xtremejames1/boatagent/results/parts/preview.png

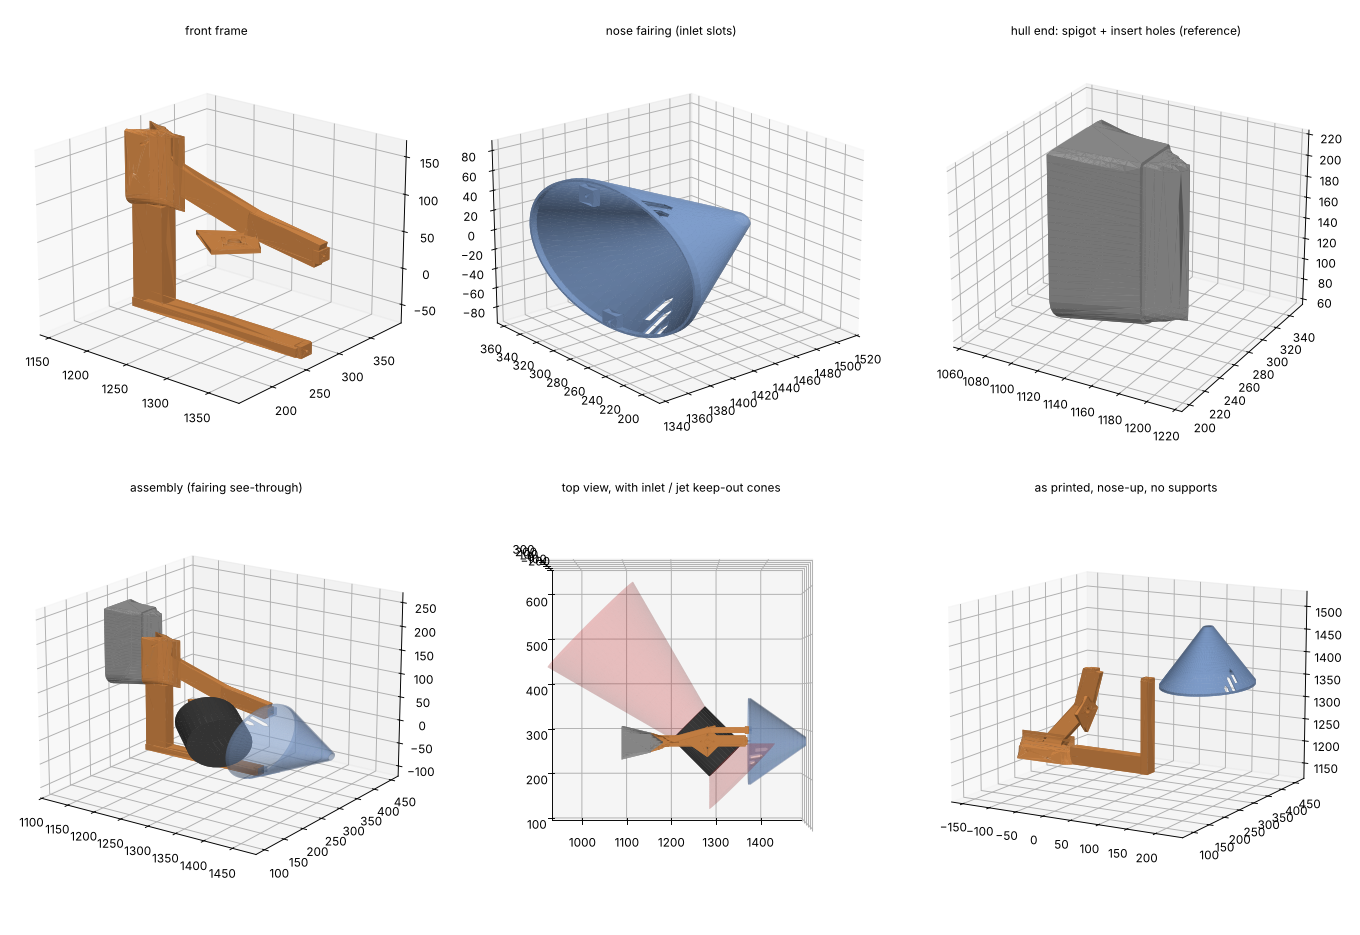
results/parts/preview.png
