xtremejames1/boatagent/results/stage2/designs/finalist_6_assembly.stl

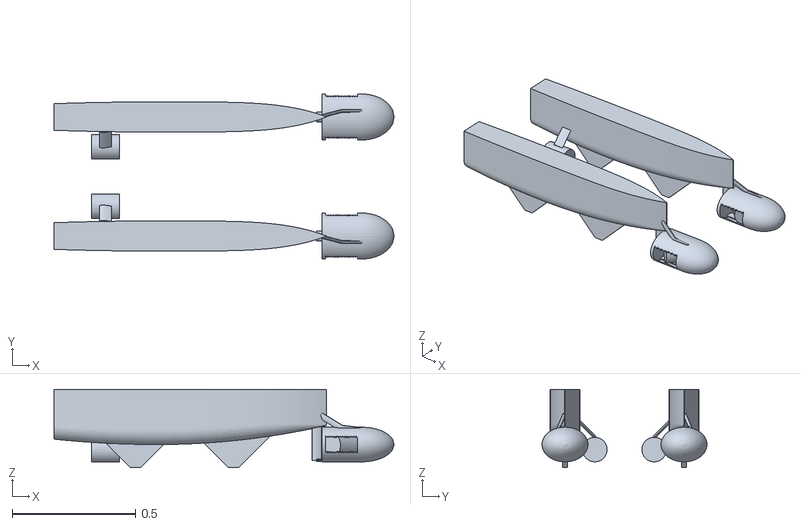
[picture p2: CAD file, 2026-10-28]
results/stage2/designs/finalist_6_assembly.stl
1.38 x 0.67 x 0.317
