xtremejames1/boatagent/results/stage2/designs/finalist_3_assembly.stl

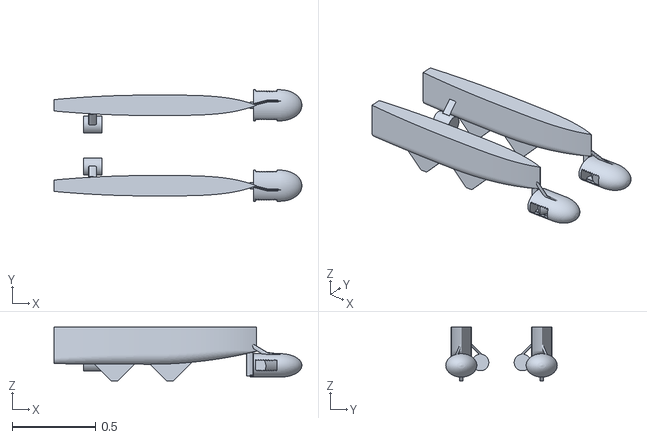
[picture p3: CAD file, 2026-10-28]
results/stage2/designs/finalist_3_assembly.stl
1.49 x 0.67 x 0.324
