xtremejames1/boatagent/results/parts/front_assembly.stl

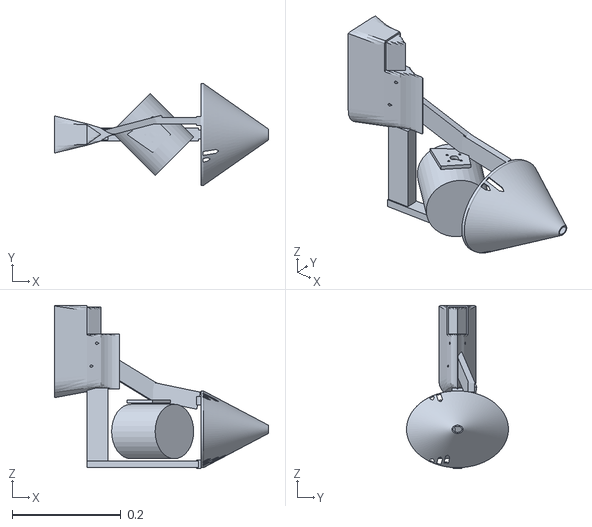
[picture p4: CAD file, 2026-10-28]
results/parts/front_assembly.stl
0.393 x 0.187 x 0.299
