xtremejames1/boatagent/results/stage2/designs/finalist_8_assembly.stl

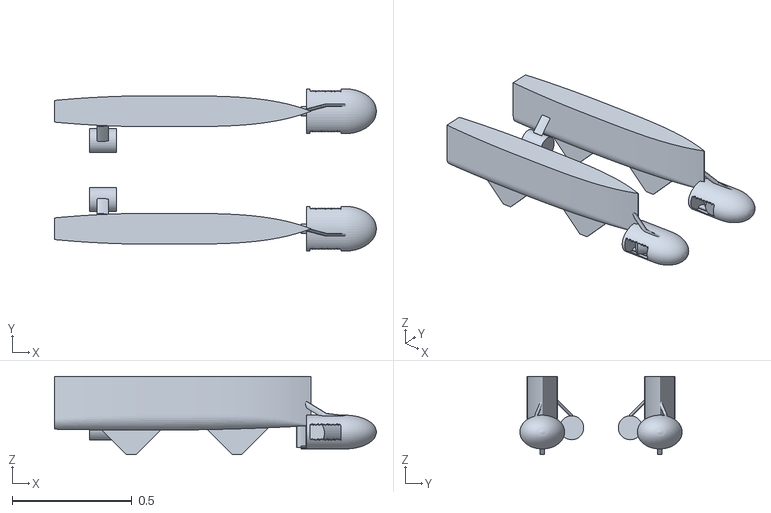
[picture p5: CAD file, 2026-10-28]
results/stage2/designs/finalist_8_assembly.stl
1.34 x 0.677 x 0.325
