xtremejames1/boatagent/results/stage2/designs/finalist_1_assembly.stl

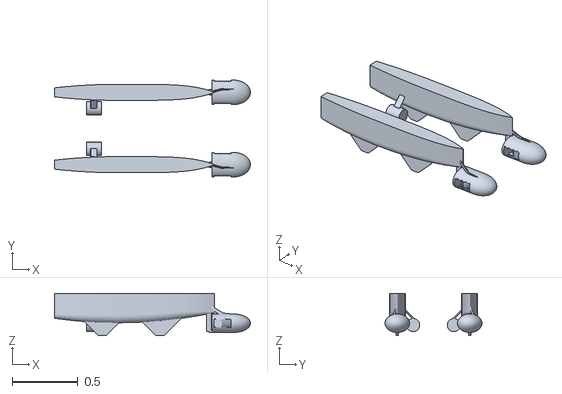
[picture p6: CAD file, 2026-10-28]
results/stage2/designs/finalist_1_assembly.stl
1.49 x 0.737 x 0.321
