xtremejames1/boatagent/results/parts/front_frame_print.stl

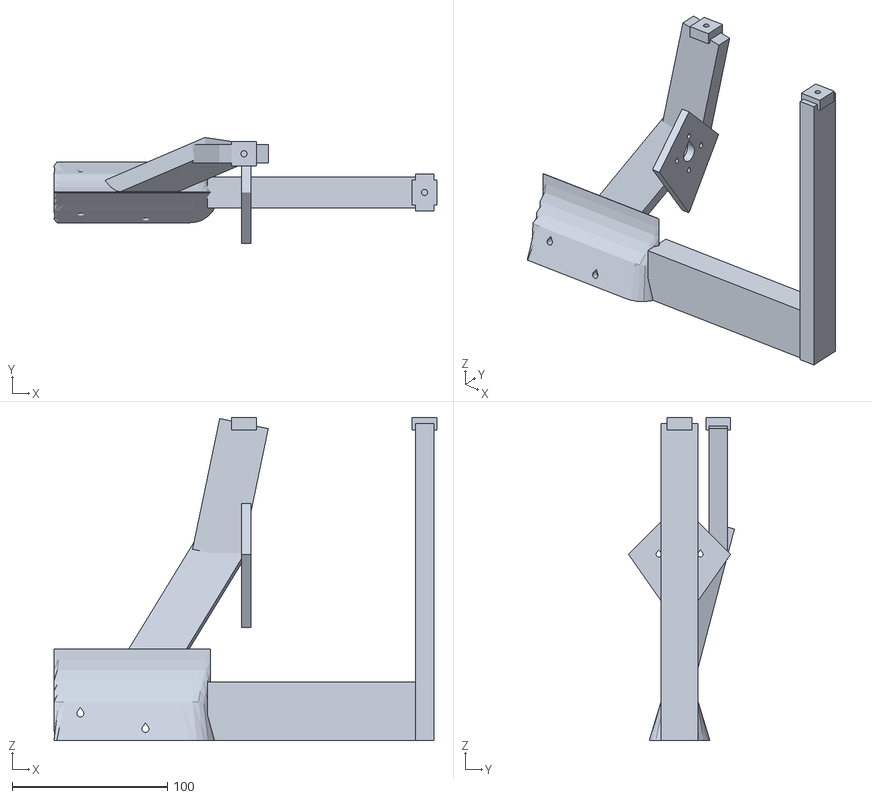
[picture p7: CAD file, 2026-10-28]
results/parts/front_frame_print.stl
247.0 x 68.4 x 208.4
