xtremejames1/boatagent/results/stage1/designs/min_mass_catamaran.stl

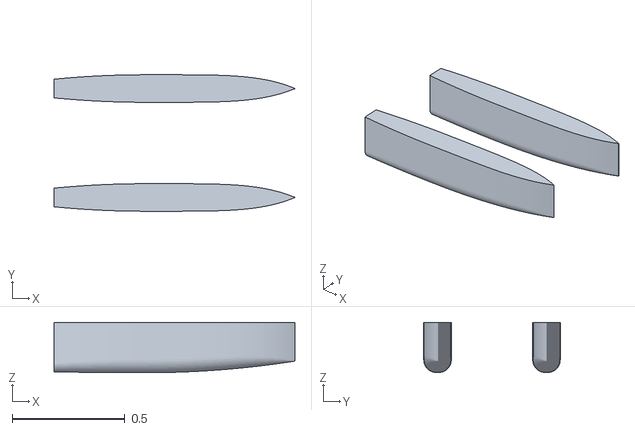
[picture p8: CAD file, 2026-10-28]
results/stage1/designs/min_mass_catamaran.stl
1.07 x 0.606 x 0.224
