xtremejames1/boatagent/results/test_hull_2ft/demihull_smooth.step

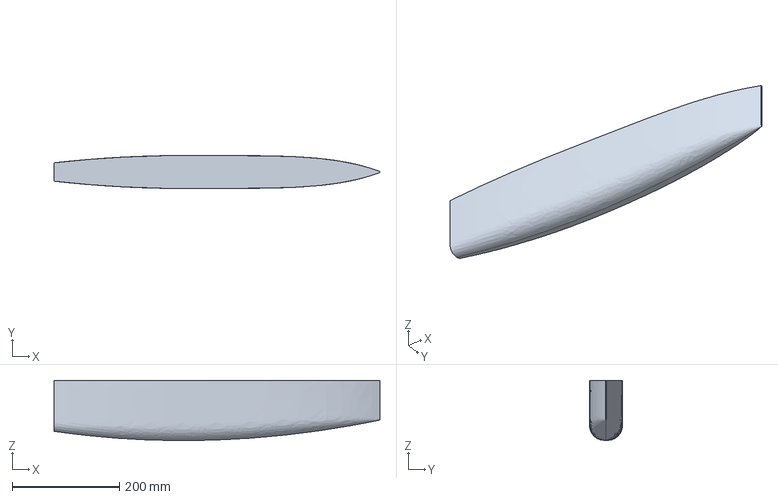
[picture p9: CAD file, 2026-10-28]
results/test_hull_2ft/demihull_smooth.step
607.2 x 61.4 x 112.1 mm
