xtremejames1/boatagent/results/test_hull_2ft_8kg/catamaran.stl

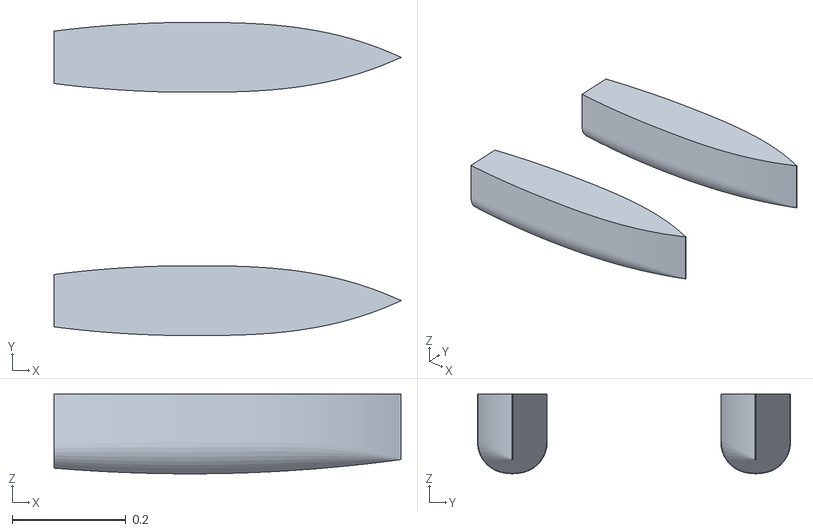
[picture p10: CAD file, 2026-10-28]
results/test_hull_2ft_8kg/catamaran.stl
0.61 x 0.55 x 0.14
