xtremejames1/boatagent/results/parts/front_fairing_print.stl

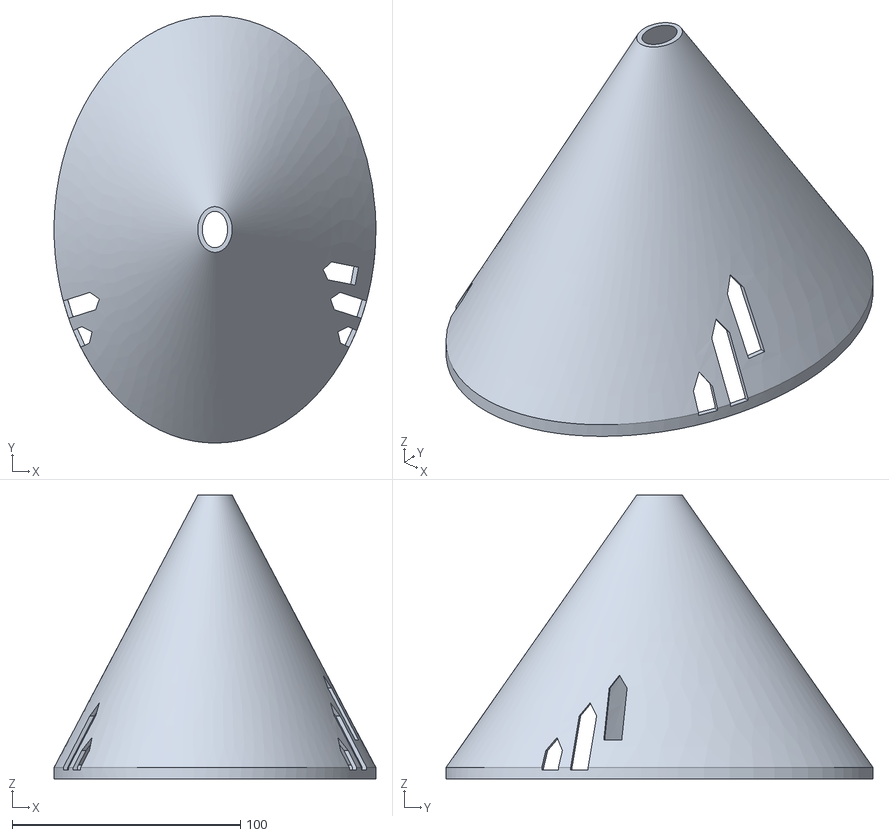
[picture p11: CAD file, 2026-10-28]
results/parts/front_fairing_print.stl
141.0 x 187.0 x 124.3
