xtremejames1/boatagent/results/stage1/designs/min_drag_catamaran.stl

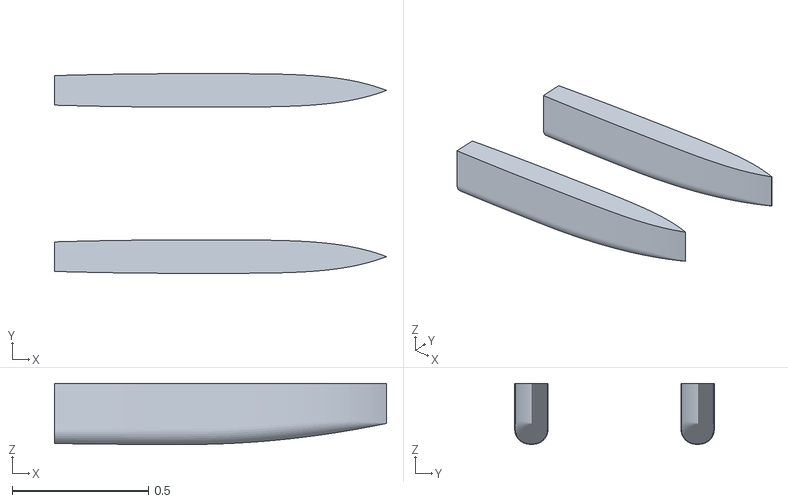
[picture p12: CAD file, 2026-10-28]
results/stage1/designs/min_drag_catamaran.stl
1.22 x 0.732 x 0.224
