xtremejames1/boatagent/results/stage2/designs/finalist_2_catamaran.stl

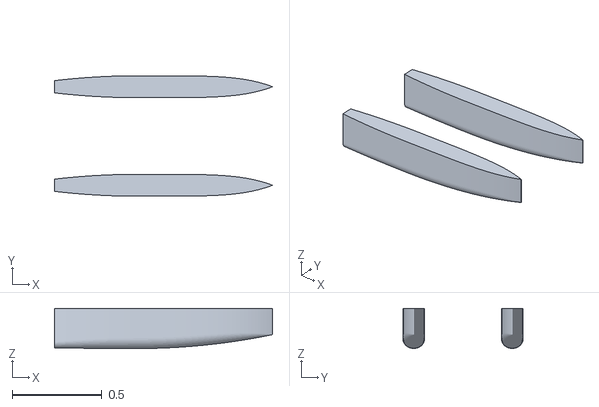
[picture p13: CAD file, 2026-10-28]
results/stage2/designs/finalist_2_catamaran.stl
1.22 x 0.672 x 0.224
