xtremejames1/boatagent/results/test_hull_2ft/demihull_piece1.step

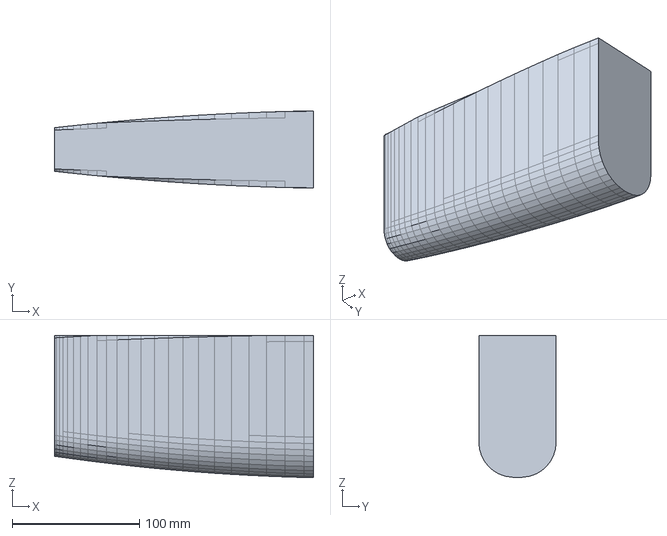
[picture p14: CAD file, 2026-10-28]
results/test_hull_2ft/demihull_piece1.step
203.2 x 60.7 x 111.7 mm
