xtremejames1/boatagent/results/test_hull_2ft_8kg/demihull_smooth.step

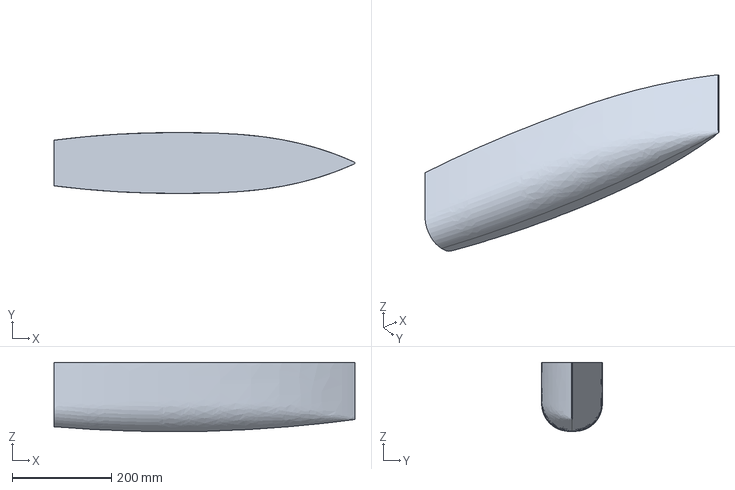
[picture p15: CAD file, 2026-10-28]
results/test_hull_2ft_8kg/demihull_smooth.step
607.2 x 122.7 x 140.0 mm
