xtremejames1/boatagent/results/test_hull_2ft_8kg/demihull.stl

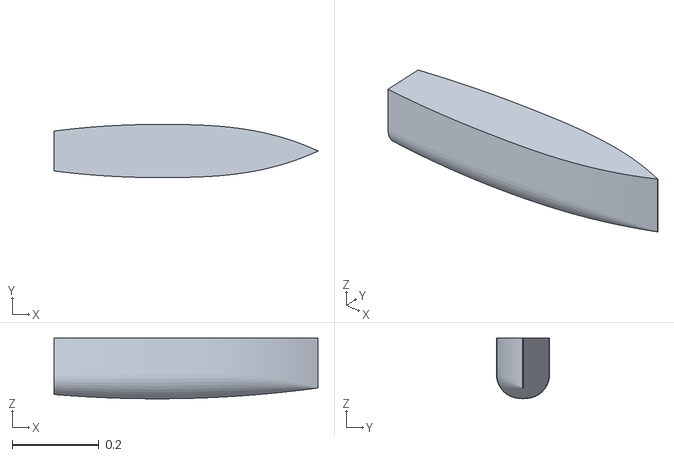
[picture p16: CAD file, 2026-10-28]
results/test_hull_2ft_8kg/demihull.stl
0.61 x 0.123 x 0.14
