xtremejames1/boatagent/results/parts/front_keepout_cones.stl

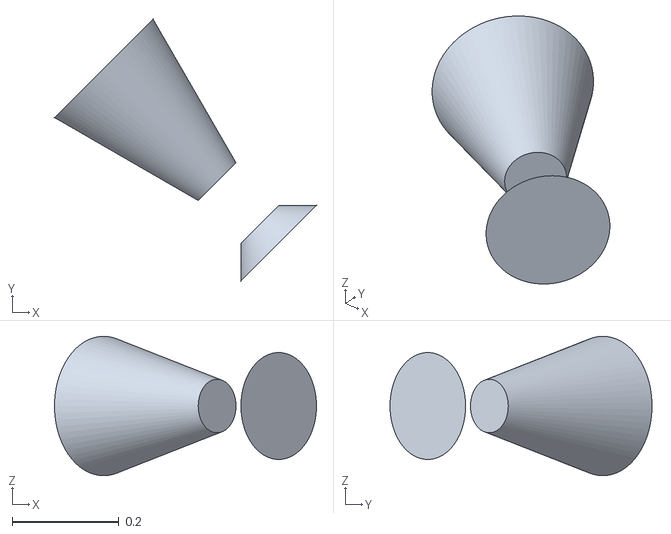
[picture p17: CAD file, 2026-10-28]
results/parts/front_keepout_cones.stl
0.49 x 0.49 x 0.261
