xtremejames1/boatagent/results/test_hull_2ft/demihull_piece2_print.stl

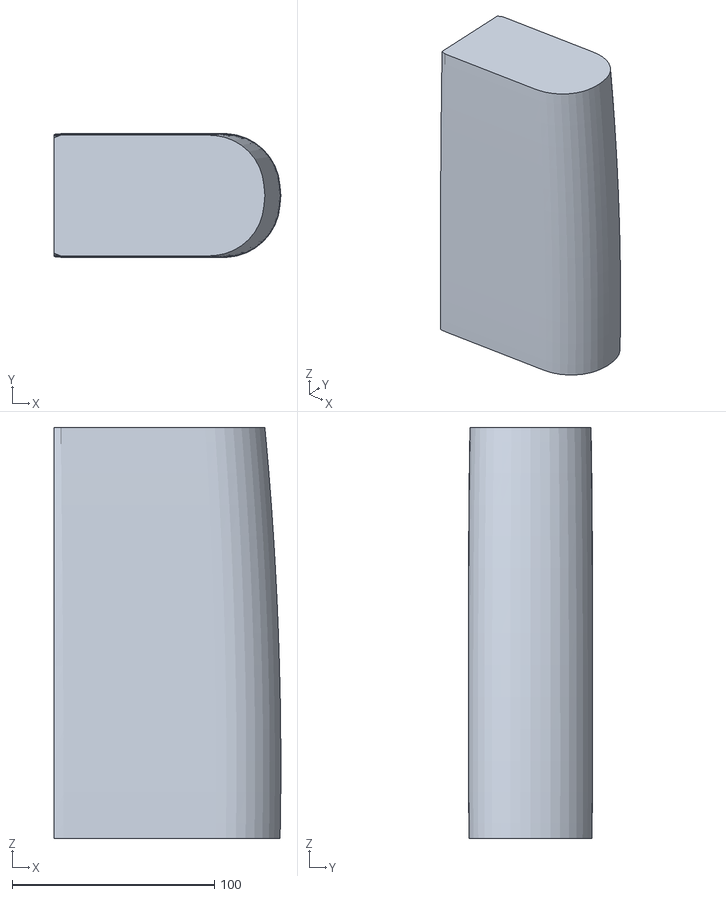
[picture p18: CAD file, 2026-10-28]
results/test_hull_2ft/demihull_piece2_print.stl
112.1 x 61.3 x 203.2
