xtremejames1/boatagent/results/parts/hull_bow_spigot.step

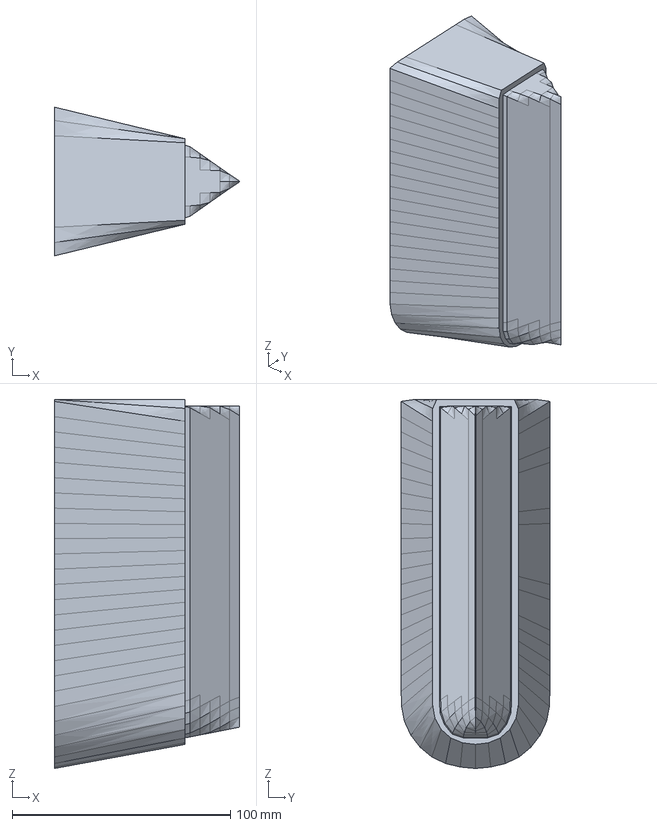
[picture p19: CAD file, 2026-10-28]
results/parts/hull_bow_spigot.step
85.0 x 68.2 x 169.3 mm
