xtremejames1/boatagent/results/test_hull_2ft/catamaran.stl

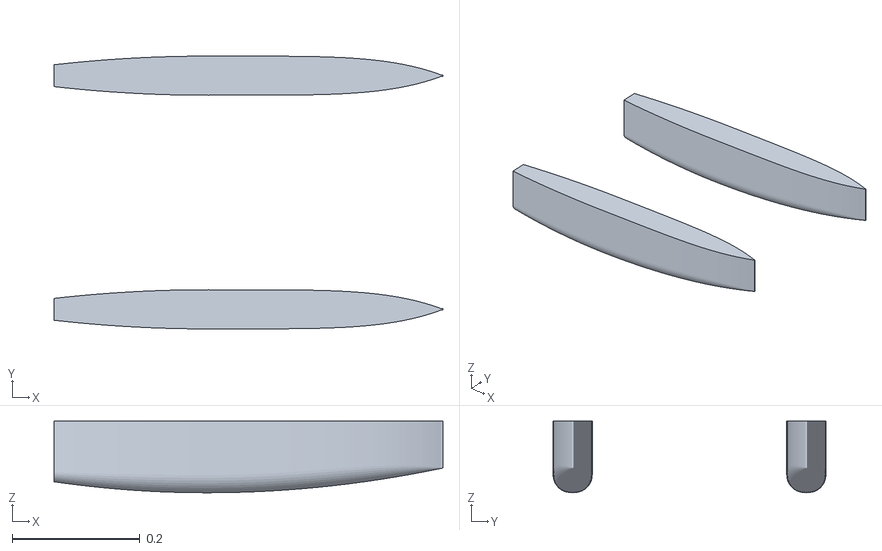
[picture p20: CAD file, 2026-10-28]
results/test_hull_2ft/catamaran.stl
0.61 x 0.427 x 0.112
