xtremejames1/boatagent/results/stage2/designs/finalist_1_pod.stl

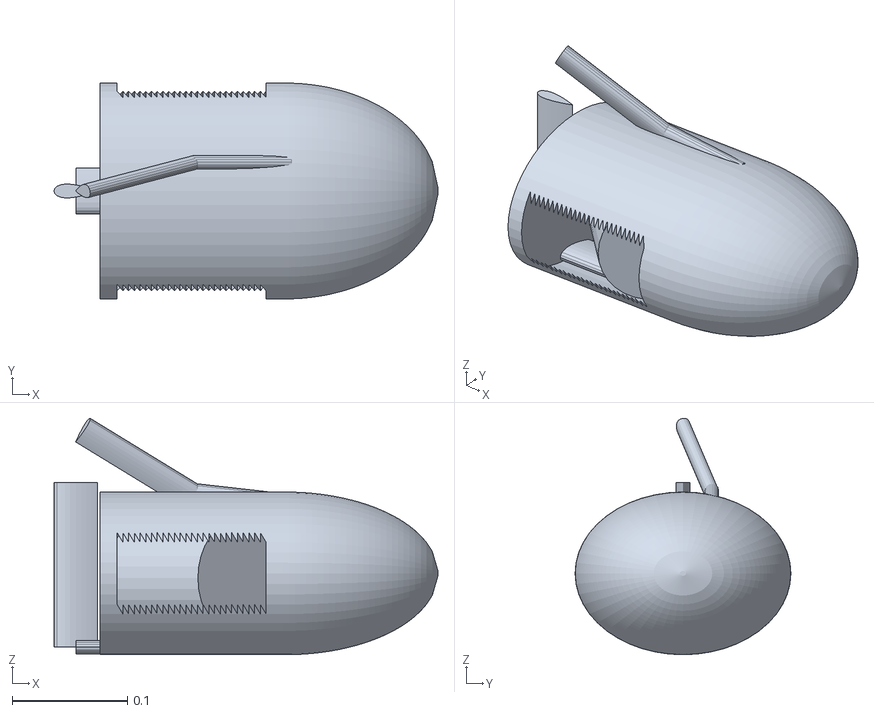
[picture p21: CAD file, 2026-10-28]
results/stage2/designs/finalist_1_pod.stl
0.333 x 0.187 x 0.205
