xtremejames1/boatagent/results/test_hull_2ft/demihull_piece3.step

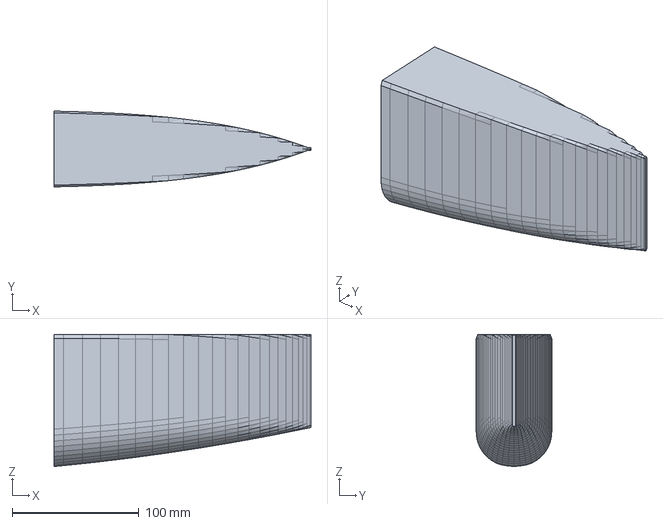
[picture p22: CAD file, 2026-10-28]
results/test_hull_2ft/demihull_piece3.step
202.8 x 59.8 x 104.2 mm
