xtremejames1/boatagent/results/stage2/designs/finalist_3_catamaran.stl

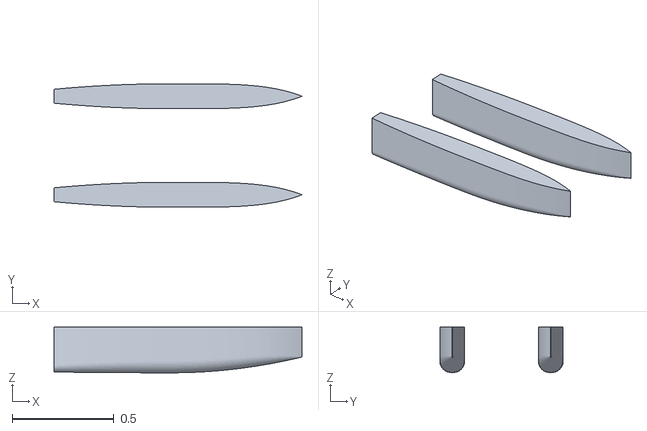
[picture p23: CAD file, 2026-10-28]
results/stage2/designs/finalist_3_catamaran.stl
1.22 x 0.606 x 0.224
