xtremejames1/boatagent/results/stage2/designs/finalist_7_pod.stl

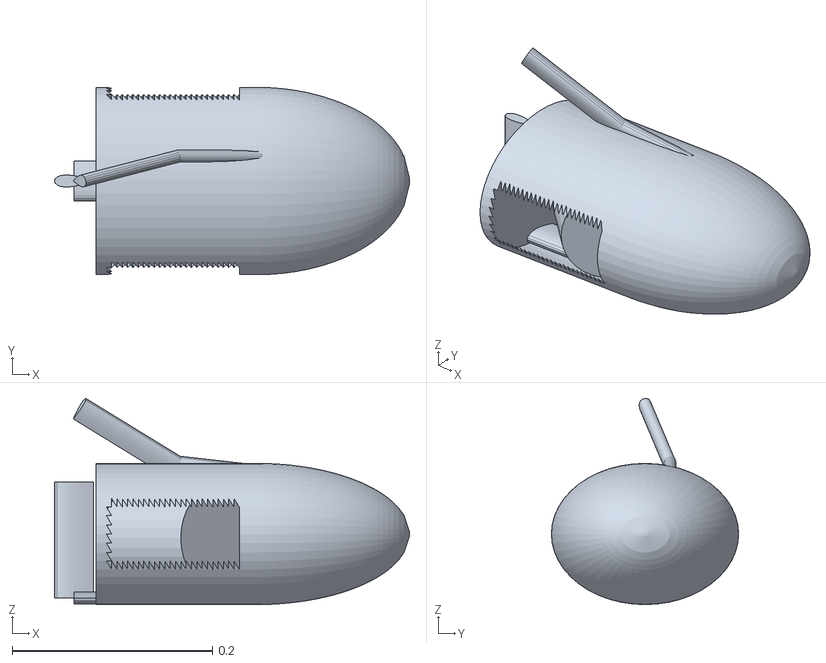
[picture p24: CAD file, 2026-10-28]
results/stage2/designs/finalist_7_pod.stl
0.355 x 0.187 x 0.206
