xtremejames1/boatagent/results/stage2/designs/finalist_4_pod.stl

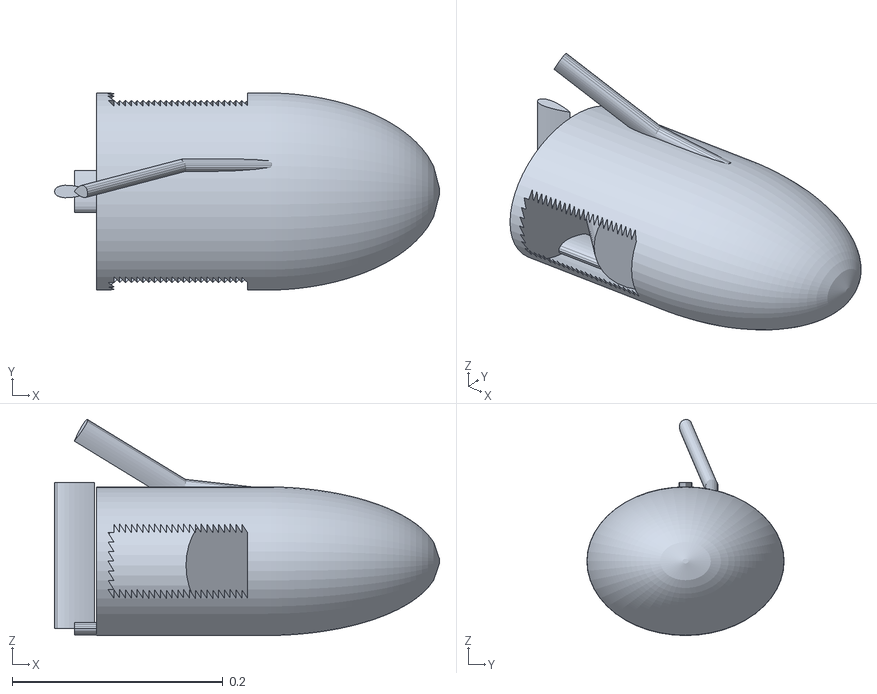
[picture p25: CAD file, 2026-10-28]
results/stage2/designs/finalist_4_pod.stl
0.365 x 0.187 x 0.205
