xtremejames1/boatagent/results/stage2/designs/finalist_5_pod.stl

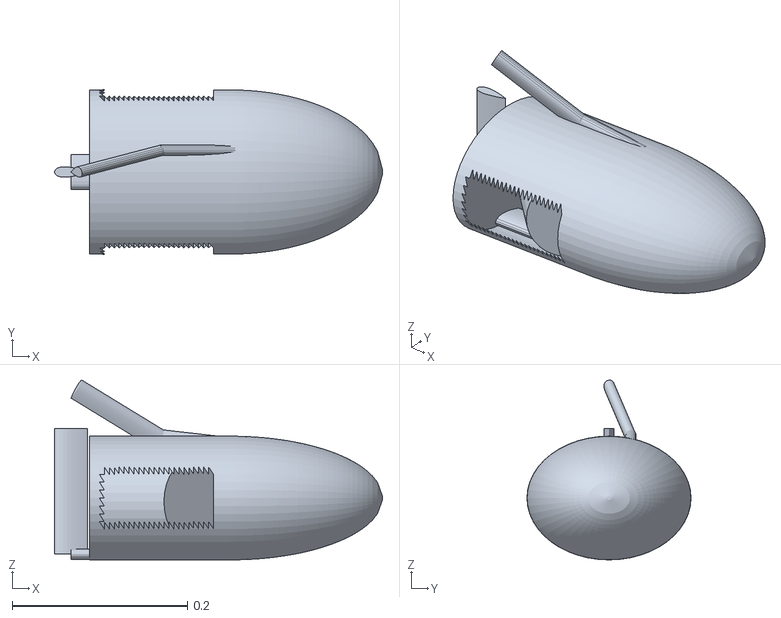
[picture p26: CAD file, 2026-10-28]
results/stage2/designs/finalist_5_pod.stl
0.374 x 0.187 x 0.205
