xtremejames1/boatagent/results/stage2/designs/finalist_8_catamaran.stl

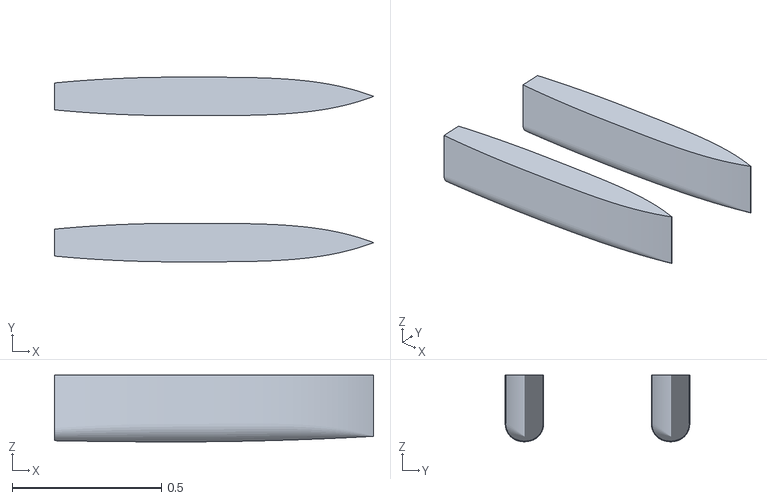
[picture p27: CAD file, 2026-10-28]
results/stage2/designs/finalist_8_catamaran.stl
1.07 x 0.619 x 0.224
