xtremejames1/boatagent/(list of files, cad)

Other CAD files:
results/stage2/designs/finalist_5_assembly.stl
results/stage2/designs/finalist_4_assembly.stl
results/stage2/designs/finalist_7_assembly.stl
results/stage2/designs/finalist_2_assembly.stl
results/parts/front_frame.step
results/stage1/designs/max_slenderness_catamaran.stl
results/stage2/designs/finalist_6_catamaran.stl
results/test_hull_2ft/demihull_piece1_print.stl
results/stage1/designs/knee_catamaran.stl
results/stage2/designs/finalist_1_catamaran.stl
results/parts/front_fairing.step
results/test_hull_2ft/demihull.step
results/test_hull_2ft/demihull_piece3_print.stl
results/test_hull_2ft/demihull_piece2.step
results/stage2/designs/finalist_6_pod.stl
results/stage2/designs/finalist_3_pod.stl
results/stage2/designs/finalist_7_catamaran.stl
results/stage2/designs/finalist_4_catamaran.stl
results/stage2/designs/finalist_2_pod.stl
results/stage2/designs/finalist_5_catamaran.stl
results/stage2/designs/finalist_8_pod.stl
results/parts/front_fairing.stl
results/parts/front_frame.stl
results/parts/hull_bow_spigot.stl
results/test_hull_2ft/demihull.stl
