xtremejames1/boatagent/results/stage1/summary.md

# Stage 1 summary

- evaluations: 3000 in 527 s
- feasible: 1280
- Pareto front (mass, friction drag, slenderness): 22
- stage 2 candidates: 200

## Constraint violations (count over all evaluations)

- skid_height: 1258
- pod_print: 401
- loa: 390
- reserve: 249
- strut_size: 196
- gm_t: 189
- clearance: 154
- width: 116
- heel_sway: 115
- freeboard: 100
- jet: 3
- skid_lcg: 3

## Representative Pareto designs

| design | loa | beam | depth | spacing_inner | lwl | draft_hull | mass_total | drag_fric_weighted | slenderness | gm_t | freeboard | trim_deg | heel_sway_deg | print_pieces_per_hull |
|---|---|---|---|---|---|---|---|---|---|---|---|---|---|---|
| min_mass | 1.07 | 0.122 | 0.224 | 0.361 | 1.07 | 0.121 | 25.2 | 4.08 | 4.6 | 0.315 | 0.102 | 0 | 3.72 | 5 |
| min_drag | 1.22 | 0.122 | 0.224 | 0.487 | 1.22 | 0.112 | 26.4 | 4.19 | 5.15 | 0.726 | 0.112 | 0 | 1.74 | 5 |
| max_slenderness | 1.23 | 0.122 | 0.224 | 0.487 | 1.23 | 0.105 | 26.1 | 4.21 | 5.24 | 0.743 | 0.119 | 0 | 1.68 | 5 |
| knee | 1.22 | 0.122 | 0.224 | 0.427 | 1.22 | 0.116 | 25.6 | 4.12 | 5.2 | 0.537 | 0.108 | 0 | 2.27 | 5 |
