xtremejames1/boatagent/results/stage2/summary.md

# Stage 2 summary

- designs: 200 (186 evaluated) in 65 s
- Pareto front on (weighted R_T 0.5-1.5 m/s, mass, sway drag): 25
- finalists for stage 3: 8

## Finalists

| name | loa | beam | depth | spacing_inner | mass_total | slenderness | R_T_weighted | R_hull_weighted | R_wave_weighted | R_app_weighted | R_T_top | thrust_margin_top | sway_drag_s2 | v_sway_max_s2 | yaw_rate_max_dps | gm_t | skid_max_height |
|---|---|---|---|---|---|---|---|---|---|---|---|---|---|---|---|---|---|
| finalist_1 | 1.22 | 0.122 | 0.224 | 0.427 | 25.7 | 5.2 | 16.7 | 4.84 | 1.51 | 11.8 | 59.1 | 2.97 | 34.8 | 0.579 | 236 | 0.536 | 0.115 |
| finalist_2 | 1.22 | 0.122 | 0.224 | 0.427 | 25.6 | 5.2 | 16.7 | 4.98 | 1.27 | 11.7 | 58.5 | 3.01 | 33.6 | 0.589 | 239 | 0.537 | 0.108 |
| finalist_3 | 1.22 | 0.122 | 0.224 | 0.361 | 25.5 | 5.21 | 16.8 | 5.12 | 1.42 | 11.7 | 58.7 | 2.99 | 33.6 | 0.589 | 230 | 0.363 | 0.104 |
| finalist_4 | 1.16 | 0.122 | 0.224 | 0.361 | 25.4 | 4.95 | 16.9 | 5.25 | 1.75 | 11.6 | 59.3 | 2.96 | 35.4 | 0.574 | 242 | 0.346 | 0.112 |
| finalist_5 | 1.16 | 0.122 | 0.224 | 0.361 | 25.5 | 4.95 | 16.9 | 5.34 | 1.25 | 11.5 | 58.4 | 3.01 | 34.3 | 0.583 | 250 | 0.367 | 0.115 |
| finalist_6 | 1.11 | 0.122 | 0.224 | 0.361 | 25.2 | 4.76 | 17.3 | 5.58 | 1.4 | 11.7 | 59.6 | 2.95 | 32.9 | 0.596 | 261 | 0.349 | 0.111 |
| finalist_7 | 1.07 | 0.122 | 0.224 | 0.361 | 25.2 | 4.6 | 17.5 | 5.98 | 1.83 | 11.5 | 59.8 | 2.94 | 33.7 | 0.588 | 240 | 0.315 | 0.108 |
| finalist_8 | 1.07 | 0.129 | 0.224 | 0.361 | 25.3 | 4.59 | 17.6 | 6.02 | 1.86 | 11.6 | 59.9 | 2.93 | 32.5 | 0.599 | 248 | 0.345 | 0.108 |

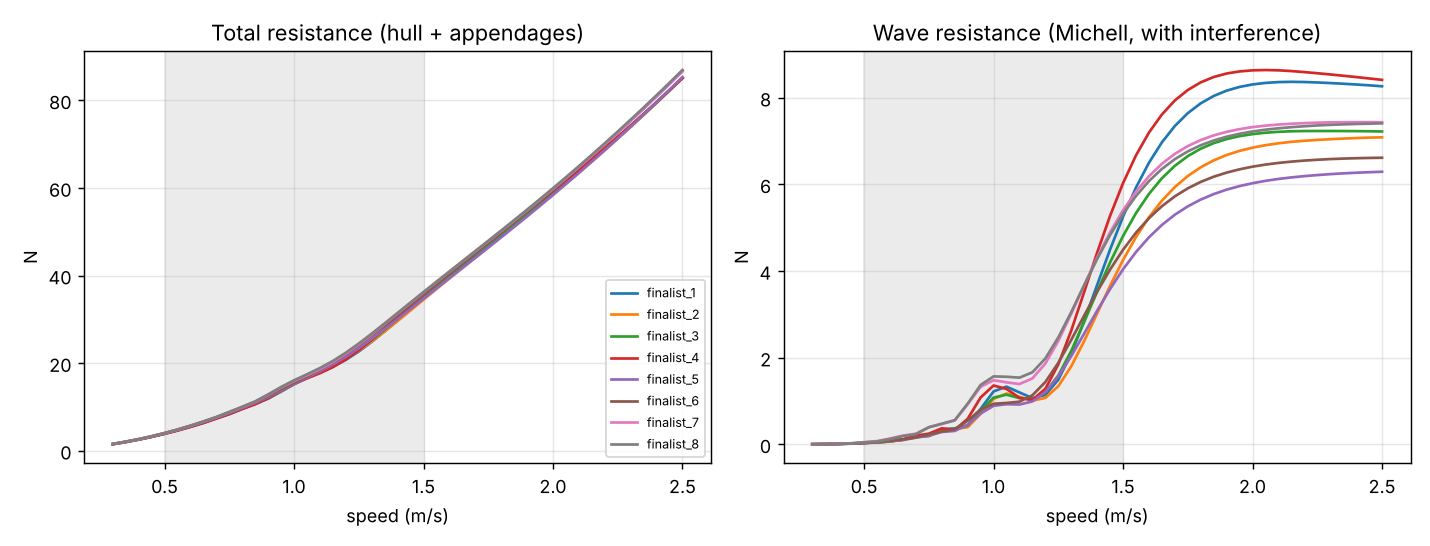
[picture p28: results/stage2/resistance.png]
resistance curves
