xtremejames1/boatagent/results/stage2/curves.csv

U | Fr | R_wave | R_visc | R_app | R_transom | R_total | interference | design
0.3 | 0.0868375 | 0.00142365 | 0.278058 | 1.11908 | 0.0868111 | 1.48537 | 1.00006 | finalist_1
0.35 | 0.10131 | 0.00368991 | 0.365206 | 1.49137 | 0.116253 | 1.97652 | 0.999004 | finalist_1
0.4 | 0.115783 | 0.0104536 | 0.462756 | 1.91429 | 0.149351 | 2.53685 | 0.999123 | finalist_1
0.45 | 0.130256 | 0.0156597 | 0.570461 | 2.38737 | 0.185871 | 3.15936 | 1.00493 | finalist_1
0.5 | 0.144729 | 0.0313689 | 0.688112 | 2.9102 | 0.22558 | 3.85526 | 0.989628 | finalist_1
0.55 | 0.159202 | 0.043588 | 0.815528 | 3.48246 | 0.268244 | 4.60982 | 0.970017 | finalist_1
0.6 | 0.173675 | 0.0668914 | 0.952548 | 4.10383 | 0.313631 | 5.4369 | 0.971852 | finalist_1
0.65 | 0.188148 | 0.107962 | 1.09903 | 4.77405 | 0.361506 | 6.34255 | 1.06231 | finalist_1
0.7 | 0.202621 | 0.201668 | 1.25485 | 5.49289 | 0.411636 | 7.36104 | 0.951135 | finalist_1
0.75 | 0.217094 | 0.200145 | 1.41988 | 6.26012 | 0.463787 | 8.34393 | 1.11154 | finalist_1
0.8 | 0.231567 | 0.342083 | 1.59403 | 7.07554 | 0.517727 | 9.52938 | 0.956745 | finalist_1
0.85 | 0.24604 | 0.368834 | 1.77719 | 7.93899 | 0.573222 | 10.6582 | 0.940135 | finalist_1
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
