xtremejames1/boatagent/results/stage2/pareto.csv

loa | beam | depth | deadrise_deg | bilge_frac | rocker_fwd | rocker_aft | entry_half_angle_deg | transom_frac | xmax_frac | spacing_inner | front_thr_gap | rear_thr_x_frac | front_thr_cover | rear_thr_cover | skid_margin | skid_aft_x_frac | skid_fwd_x_frac | skid_pad_len | pod_wall | pod_nose_len | feasible | fail_reason | obj_mass | obj_drag | obj_slenderness | mass_total | mass_hulls | mass_frame | mass_lidar | mass_thrusters | mass_pods | mass_mounts | mass_skids | mass_payload | hull_printed_each | print_pieces_per_hull | lcg | vcg | payload_x | heave | trim_deg | draft_hull | draft_total | freeboard | gm_t | gm_l | lwl | bwl | cb | cwp | loa_overall | width | slenderness | reserve_buoyancy | wetted_hulls | entry_angle_actual_deg | fr_0.5 | fr_0.75 | fr_1
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
