xtremejames1/boatagent/results/test_hull_2ft/preview.png

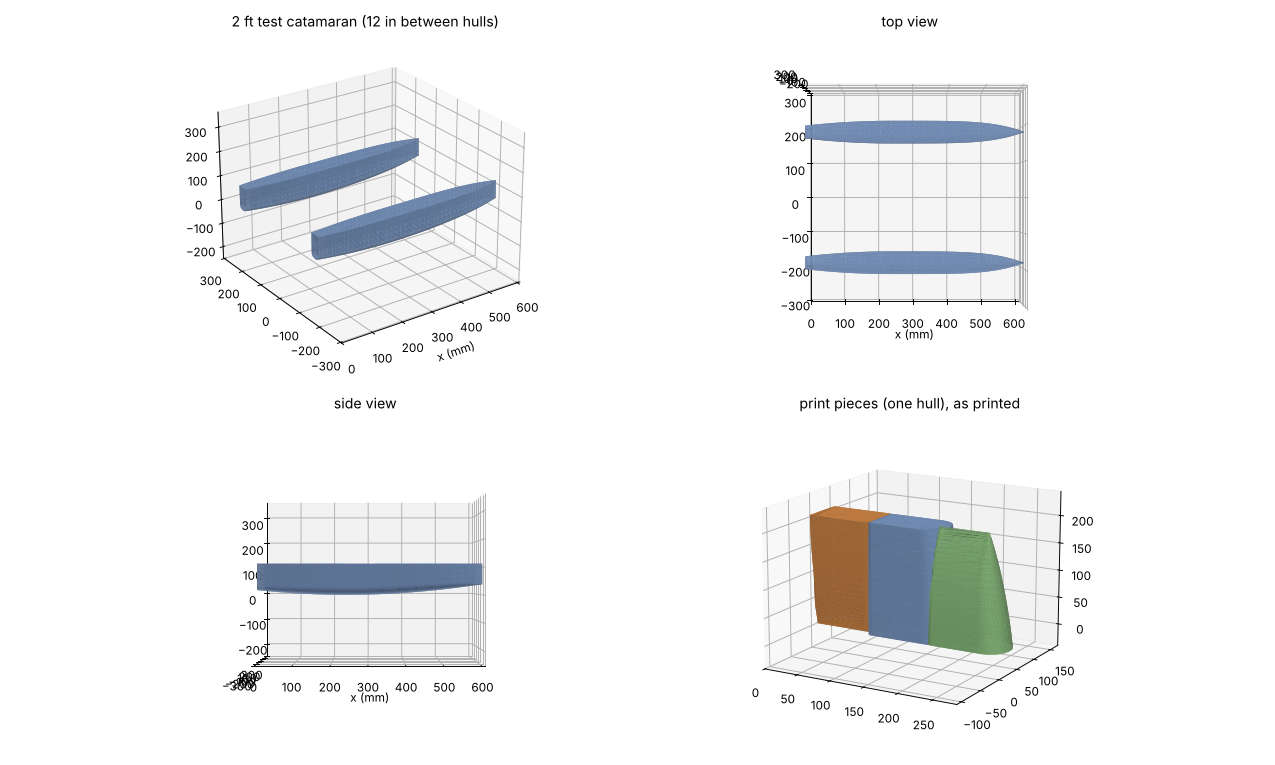
results/test_hull_2ft/preview.png
