xtremejames1/boatagent/(commit log)

2026-10-27 Add stage 1 hull screening: geometry, hydrostatics, mass, checks, NSGA-II
    Parametric demihull/catamaran mesh, clipped-mesh hydrostatics with free
    heave and trim, printed-mass model with print-bed segmentation, thruster/
    shroud/skid placement with clearance and jet checks, friction proxy, and
    an Optuna NSGA-II driver that writes stage 2 candidates.
    Claude-Session: https://claude.ai/code/session_01RXSeLSV1JptZNWH4XrVYfF
2026-10-27 Add first stage 1 run results (3000 evals, 200 stage 2 candidates)
    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
    [knee_catamaran.stl, max_slenderness_catamaran.stl, min_drag_catamaran.stl, min_mass_catamaran.stl, pareto.csv, stage2_candidates.csv]
2026-10-27 Add stage 2: Michell wave resistance with interference, drag build-up, sway and yaw
    Michell thin-ship integral with exact panel integration and demihull
    interference, ITTC-57 with Couser catamaran form factor, appendage and
    Holtrop transom drag, sway crossflow and yaw-rate proxies. Scores the 200
    stage 1 candidates and picks 8 finalists for stage 3.
    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
    [curves.csv, finalist_1_catamaran.stl, finalist_2_catamaran.stl, finalist_3_catamaran.stl, finalist_4_catamaran.stl, finalist_5_catamaran.stl, finalist_6_catamaran.stl, finalist_7_catamaran.stl]
2026-10-27 Mount front thrusters ahead of the bows, rear thrusters between the hulls
    Front pair: one ahead of each bow on the hull centreline, shrouded for impact
    protection, with a new front_thr_gap variable. Rear pair: unshrouded, wholly
    in the gap between the hulls. All four on 3D-printed mounts (strut, clamp,
    and a forward arm for the front pair) with mass counted. Hull loa now
    excludes the front shrouds; overall length still capped at 1.52 m.
    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
2026-10-27 Rerun stages 1 and 2 with the new thruster mount layout
    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
    [curves.csv, finalist_1_catamaran.stl, finalist_2_catamaran.stl, finalist_3_catamaran.stl, finalist_4_catamaran.stl, finalist_5_catamaran.stl, finalist_6_catamaran.stl, finalist_7_catamaran.stl]
2026-10-27 Record confirmed length limit and current shroud model in brief
    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
2026-10-27 Replace front shroud ring with a faired, crushable pod
    The front thrusters now sit at 45 deg inside a pod aligned with the flow:
    elliptical section, tail fairing, thruster bay with side windows for
    inflow, and a crushable nose. The pod covers the thruster mount and must
    print in one piece on a 250 mm bed (hull bed also set to 250 mm). Adds
    pod print, crush-length and window-area constraints, impact energy and
    crush force outputs, and Hoerner body + window drag in stage 2.
    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
2026-10-27 Rerun stages 1 and 2 with faired front pods; update findings
    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
    [curves.csv, finalist_1_catamaran.stl, finalist_2_catamaran.stl, finalist_3_catamaran.stl, finalist_4_catamaran.stl, finalist_5_catamaran.stl, finalist_6_catamaran.stl, finalist_7_catamaran.stl]
2026-10-27 Add STL export of the front pod and full assembly for viewing
    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
    [finalist_1_assembly.stl, finalist_1_pod.stl, finalist_2_assembly.stl, finalist_2_pod.stl, finalist_3_assembly.stl, finalist_3_pod.stl, finalist_4_assembly.stl, finalist_4_pod.stl]
2026-10-27 Toe-in front thrusters, fore/aft skid pads, connected mounts in export
    - Front thrusters toe in (forward end toward the centreline); jets run
    aft-outboard past the hulls.
    - Skid rail replaced by two printed trapezoid pads per hull, fore and aft;
    LCG must sit between them.
    - Export draws the front arm from the bow stem to the pylon and the rear
    crossbeam the rear struts hang from.
    - Yaw torque uses the actual front thruster heading.
    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
2026-10-27 Rerun stages 1 and 2 with toe-in, skid pads and mount meshes
    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
    [curves.csv, finalist_1_assembly.stl, finalist_1_catamaran.stl, finalist_1_pod.stl, finalist_2_assembly.stl, finalist_2_catamaran.stl, finalist_2_pod.stl, finalist_3_assembly.stl]
2026-10-27 Rear thrusters on diagonal struts into the hull sides, no crossbeam
    Each rear strut runs outboard and up at 45 deg from the thruster top until it
    meets its own hull. Strut section 48 x 12 mm with a 24 x 12 mm minimum
    (c_strut_size). Strut model generalised to diagonal members (length,
    submerged length/height/centre); export follows the strut axis.
    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
2026-10-27 Front pods hang from two diagonal bow members instead of arm + pylon
    Upper member: stem top down to the pod top. Lower member: low on the stem
    to the pod tail. Both 48 x 12 mm (min 24 x 12, now checked for every mount
    member). Strut model generalised to any two end points; front members get
    friction plus pressure drag on their 12 mm face. Pylon design variables
    removed.
    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
2026-10-27 Rerun stages 1 and 2 with bow-member brackets and diagonal rear struts
    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
    [curves.csv, finalist_1_assembly.stl, finalist_1_catamaran.stl, finalist_1_pod.stl, finalist_2_assembly.stl, finalist_2_catamaran.stl, finalist_2_pod.stl, finalist_3_assembly.stl]
2026-10-28 Flat bow face for the mount plate, bracket to a T200 plate, PLA
    - Hull ends in a flat bow face (bow_face_width 60-80 mm) that the front
    bracket's back plate bolts to (4x M4, 40 x 60 mm pattern).
    - Front members run from the back plate to a plate on top of the T200
    (4x M3 on 19 mm, base offset placeholder); the pod section grows upward
    to enclose that plate.
    - Michell sees the blunt bow (offsets closed just ahead of the face).
    - Filament density set to PLA.
    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
2026-10-28 Parametric front pod and bracket (CadQuery), slicer mass, strength check
    - hullopt/parts.py builds the front bracket (back plate with 4x M4 on 40 x 60,
    upright upper member, flat lower member, T200 plate with 4x M3 on 19 mm +
    M6, M3 inserts for the pod) and the front pod (shell, solid nose, side
    windows, open tail, top slot, screw bosses), exports STEP/STL, slices with
    PrusaSlicer (PLA, 4 walls, 10 % gyroid) and writes a report.
    - hullopt/strength.py: rigid-joint 3D frame check of the mount members
    (stress, Euler buckling) and the hull bolt group, for 3x thrust, reverse,
    head-on and side hits at the pod's breakaway load (2 nylon M3, ~420 N).
    - Pod cross-section now sized to enclo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
2026-10-28 Stage 1 drag objective adds a coarse Michell wave term
    Friction alone favoured short hulls; with the larger front pods stage 1 stopped
    passing long hulls to stage 2 even though they have less total drag.
    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
2026-10-28 Front pod and bracket parts for finalist 1; rerun with wave-aware stage 1
    results/parts: STEP + STL for the front bracket and pod, front assembly STL,
    preview render and the mass / strength report (slicer: bracket 114 g, pod
    295 g, PLA 4 walls 10 % gyroid).
    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
    [curves.csv, finalist_1_assembly.stl, finalist_1_catamaran.stl, finalist_1_pod.stl, finalist_2_assembly.stl, finalist_2_catamaran.stl, finalist_2_pod.stl, finalist_3_assembly.stl]
2026-10-28 Hollow pod nose, T200 on 4x M3 only, side hits reported as capacity
    Pod 295 g -> 174 g (slicer). Side hit checked at 0.5x breakaway and reported
    as a sideways capacity (~136 N), not a pass/fail case.
    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
    [front_assembly.stl, front_bracket.step, front_bracket.stl, front_pod.step, front_pod.stl]
2026-10-28 Front mount v2: merged frame with bow cap, separate nose fairing
    Per user feedback:
    - One printed frame per side: a bow cap that slides over a spigot on the
    blunt-cut hull (4x M4 sideways into heat-set inserts) and carries the fine
    entry itself; a forefoot fin; an upper strut in two segments (cap -> T200
    plate -> fairing lug) offset outboard so all 4 M3 screws can be reached
    from above; a level rail under the thruster. Impacts go fairing -> lugs ->
    struts -> cap, not through the thruster. Thruster slides out sideways.
    - Separate nose fairing/bumper, starting at the thruster inlet, slotted where
    the inlet keep-out cone passes, nylon M3 to the lugs (break-off point).
    - Prints nose-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
2026-10-28 Rerun stages with frame v2; front frame and fairing parts for finalist 1
    results/parts: front frame (168 g, 12.8 h) and nose fairing (89 g, 6.2 h),
    sliced with PrusaSlicer (PLA, 4 walls, 10 % gyroid), print-oriented STLs,
    hull spigot reference, keep-out cones, preview and report. All primary
    strength cases pass (worst 0.99); sizing search widened to thicker members.
    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
    [curves.csv, finalist_1_assembly.stl, finalist_1_catamaran.stl, finalist_1_pod.stl, finalist_2_assembly.stl, finalist_2_catamaran.stl, finalist_2_pod.stl, finalist_3_assembly.stl]
2026-10-28 Add 2 ft test hull variant (12 in between hulls)
    hullopt/testhull.py scales a design's hull to a new length with the hull gap
    set separately, and writes STEP/STL, bed-sized print pieces, slicer masses and
    a draft-against-load table. results/test_hull_2ft: finalist 1 at 610 mm.
    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
    [catamaran.stl, demihull.step, demihull.stl, demihull_piece1.step, demihull_piece1_print.stl, demihull_piece2.step, demihull_piece2_print.stl, demihull_piece3.step]
2026-10-28 Smooth B-spline STEP of the 2 ft test demihull
    hullopt/cadhull.py lofts spline sections (keel to deck edge, deck line) into a
    5-face solid: two B-spline sides, deck, flat transom, small flat at the bow.
    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
    [demihull_smooth.step]
2026-10-28 2 ft test hull sized for 8 kg payload (smooth STEP)
    Twice the beam (123 mm), 140 mm deep, wider transom, fuller bow, less rocker;
    12 in between inner faces. 90 mm draft and 50 mm freeboard at 9.15 kg total.
    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
    [catamaran.stl, demihull.stl, demihull_smooth.step]
